darioJau/Piero-DIY-with-360-rotating-Cam/image.png

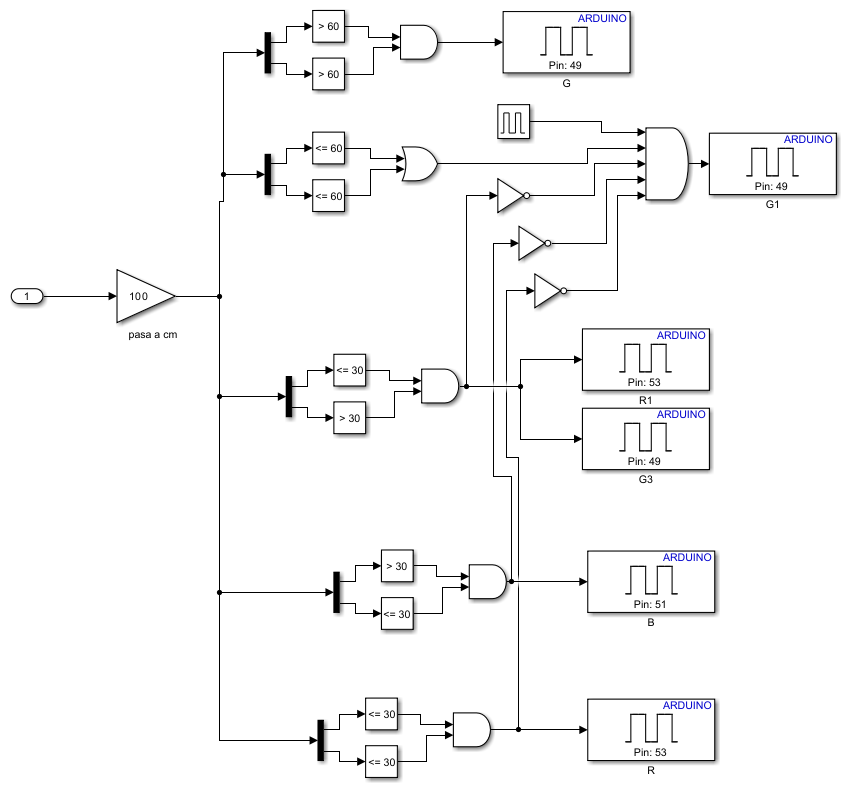
image.png
