darioJau/Piero-DIY-with-360-rotating-Cam/CodigosArdruino/Mando_GR31/joystick.stl

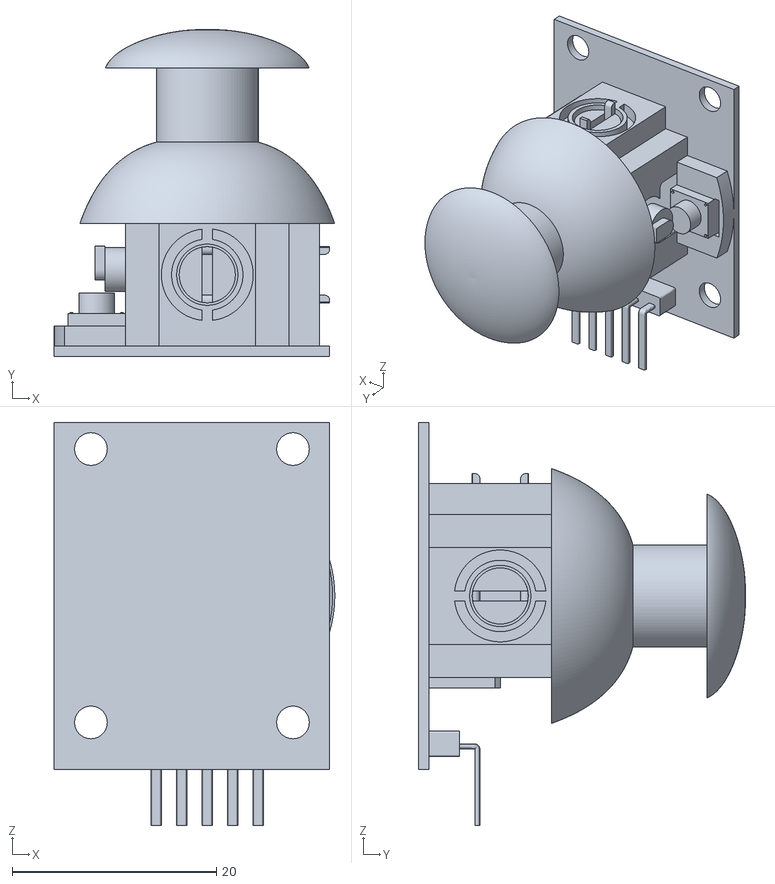
[picture p33: CAD file, 2024-01-14]
CodigosArdruino/Mando_GR31/joystick.stl
27.5 x 32.0 x 39.5
