darioJau/Piero-DIY-with-360-rotating-Cam/(list of files, cad)

Other CAD files:
CodigosArdruino/Mando_GR31/Joystick HW504 Board.SLDPRT
