darioJau/Piero-DIY-with-360-rotating-Cam/(list of files, drawings)

Other design files:
CodigosArdruino/Mando_GR31/mando.fzz
