darioJau/Piero-DIY-with-360-rotating-Cam/(commit log)

2023-10-04 Arreglo de errores iniciales
2023-10-05 tets LEDs David
2023-10-06 Control y Leds: Trabajo Para tarea viernes 06-10
2023-10-06 Borrado archivos de prueba
2023-10-06 Mitad de clase viernes 06-10
2023-10-06 Fin clase 06-10. Funcionando a espera de sensores
2023-10-12 subida de controlador para sensores de distancia
2023-10-13 Update README.md
    Actualización del trabajo de calibrado y los videos iniciales
2023-10-13 Update README.md
    Adecuando el formato del Readme
2023-10-13 Update README.md
    Mejora en el formato
2023-10-20 Intentando solucionar lo de los sensores
2023-10-23 Subida del DatosIdent y pequeños avances en los sensores
2023-10-24 Calibración sensores completa al 100%
2023-10-24 Cambio de nombre de archivos
2023-10-25 Corregido código Encoder S-Function Creado modelo TestEncoderDistancia.slx
2023-10-26 Calibración de TICKS a METROS en Test_Sfunction
2023-10-27 intento de arreglar los sensores
2023-10-27 Añado todos los archivos a la carpeta del módulo del sensor
2023-11-02 EncoderVelocidad subsystem reference
2023-11-03 Subida de la cinemática del Piero
2023-11-03 Arreglado el irs del S-Function del encoder
2023-11-04 Update README.md
    Proceso de montaje
2023-11-29 Actualizacion: Por fin sensores nuevos
2023-11-29 Update README.md
    Actualización sensores (sin matlab)
2023-11-30 Arreglo de PWM motores y también añadido irsPinAEn0 a encoders
2023-11-30 Cambios guardados y sonars como subsystem
2023-11-30 Test General de acuadores y sensores
2023-11-30 Control evita obstaculos y Test encoders funcionando
2023-12-01 Muchos avances Clase 1/12
    Falta final del 11/10 y hacer el subsistema "piero"
2023-12-02 A mitad del bloque del piero que faltaba
2023-12-02 Control en Bucle Cerrado y PIDs funcionando a la perfección
2023-12-02 Control de orientación completo y funcionando
2023-12-03 Intento de hacer dar 10 vueltas sobre sí mismo
2023-12-04 En PieroControlOrientación hay algún fallo que no logro solucionar. El PID actúa (está limitado a -1) pero los modelos cinemáticos no mandan la orden correctamente. No trata de alcanzar la consigna s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
2023-12-04 Tratando de arreglar el error del control de orientación pero sin éxito.
    Hay muchos scopes
2023-12-12 Encoders arreglados: Ya no hay overflow en la variable pos y sigue midiendo de forma continua
2023-12-12 Tocamos Los waypoints y en la teoría funcionan
2023-12-15 el piERO SALE DE LA CLASE!!!!!!!!!!!!!!!!!!!!!!!!!!!!!!!!!!!!!!!!!!!!!!!!!!!!!!!!!!!!!!!!!!!!!!!!!!! :)
2023-12-22 Modificaciones ultimo dia de clase, feliz navidad.
2023-12-26 Funcionando el salir de clase con obstáculos
2023-12-27 Update README.md
    Añadidos los de los títulos de los apartados
2023-12-27 Avances con la señalizacion. ARREGLAR Leds_BIT
2023-12-28 Update README.md
    Contron BA y BC. Escrito de nuevo despues de que se me borre
2023-12-28 Update README.md
    Añadida la cinemática del Piero
2023-12-28 Actualizado el valor de d = 0.2275 Y algunos ligeros cambios irrelevantes para rellenar el Markdown
2023-12-28 Update README.md
    MD con formato correcto. Listo para continuar con los modelos para salir de clase
2023-12-28 Modelo cargado en el piero
2023-12-28 Comprobacion salir de clase obstaculos :)
2023-12-29 Salir de clase SF
2023-12-29 Toma de datos para README.MD
2024-01-11 Update README.md
    Añadidas partes que faltan y organizados los videos
2024-01-14 Foto de portada
2024-01-14 Update README.md
    Imagen de portada
